caroolparedes/arroyo-mburicao-estacion-lluvia/README.md

# arroyo-mburicao-estacion-lluvia
Sistema de monitoreo pluviométrico distribuido a lo largo del arroyo Mburicao, basado en sensor óptico RS485 + ESP32 con transmisión WiFi/GSM y  almacenamiento en MicroSD.
