caroolparedes/arroyo-mburicao-estacion-lluvia/mechanical/Caja_P4.SLDPRT

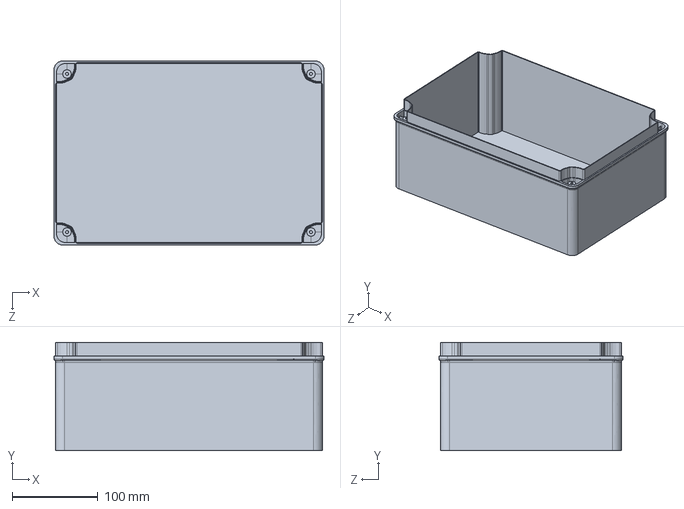
[picture p12: CAD file, 2026-03-30]
mechanical/Caja_P4.SLDPRT
314.0 x 126.0 x 214.0 mm
