caroolparedes/arroyo-mburicao-estacion-lluvia/mechanical/Soporte_Sensor_P4.SLDPRT

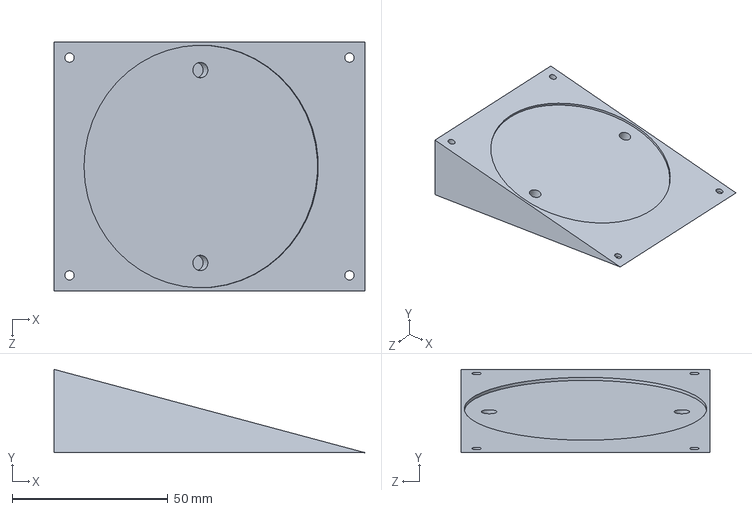
[picture p13: CAD file, 2026-03-30]
mechanical/Soporte_Sensor_P4.SLDPRT
100.0 x 26.8 x 80.0 mm
