caroolparedes/arroyo-mburicao-estacion-lluvia/mechanical/Tapa_P4.SLDPRT

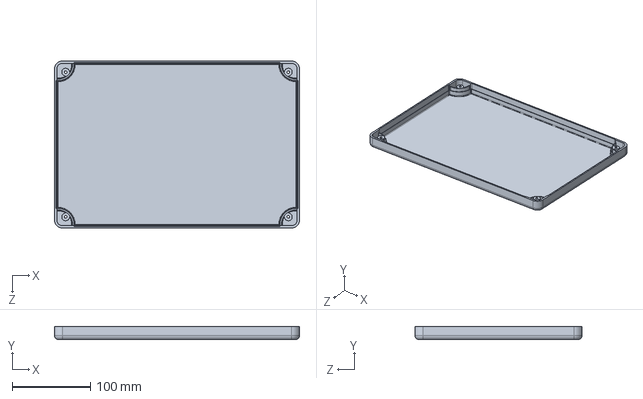
[picture p14: CAD file, 2026-03-30]
mechanical/Tapa_P4.SLDPRT
314.0 x 17.0 x 214.0 mm
